natapol2547/iot-ros/src/iot_robot_description/meshes/wheel_link_right_visual.stl

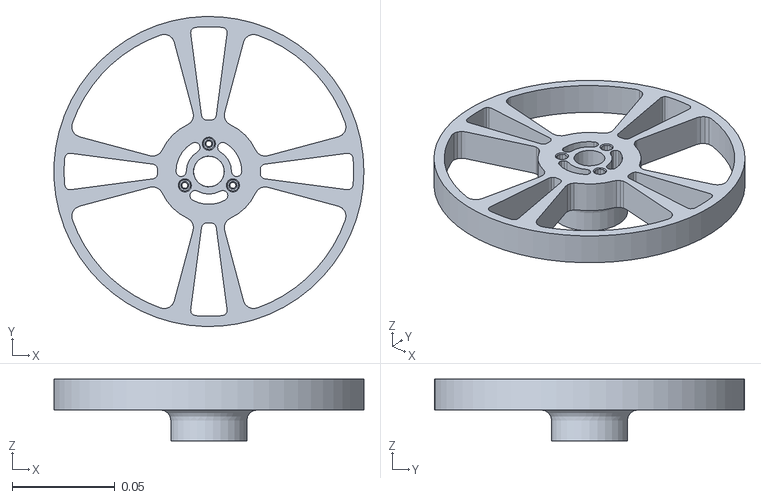
[picture p3: CAD file, 2026-09-09]
src/iot_robot_description/meshes/wheel_link_right_visual.stl
0.151 x 0.151 x 0.03
