natapol2547/iot-ros/src/iot_robot_description/meshes/gizmo_pitch_link_visual.stl

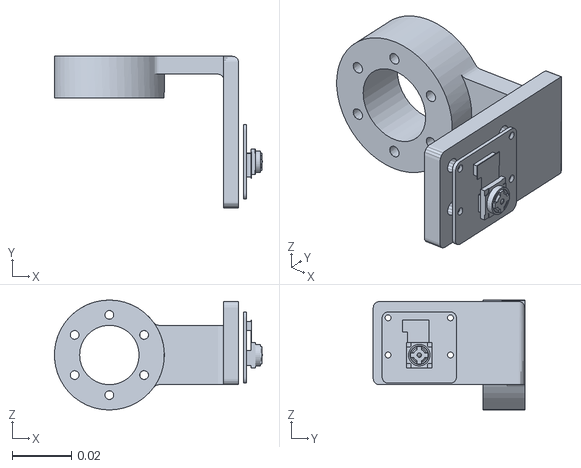
[picture p4: CAD file, 2026-09-09]
src/iot_robot_description/meshes/gizmo_pitch_link_visual.stl
0.07 x 0.051 x 0.037
