natapol2547/iot-ros/src/iot_robot_description/meshes/base_link_visual.stl

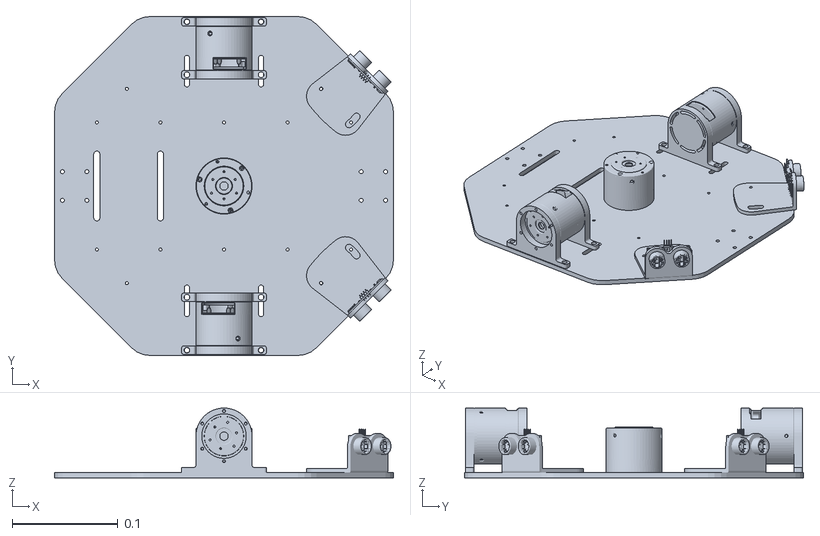
[picture p5: CAD file, 2026-09-09]
src/iot_robot_description/meshes/base_link_visual.stl
0.32 x 0.32 x 0.066
