natapol2547/iot-ros/src/iot_robot_description/meshes/gizmo_yaw_link_visual.stl

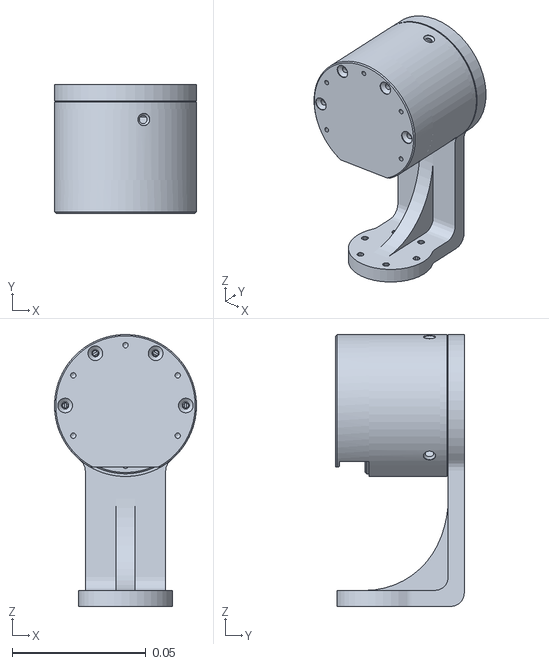
[picture p6: CAD file, 2026-09-09]
src/iot_robot_description/meshes/gizmo_yaw_link_visual.stl
0.053 x 0.048 x 0.102
