natapol2547/iot-ros/src/iot_robot_description/meshes/caster_front_visual.stl

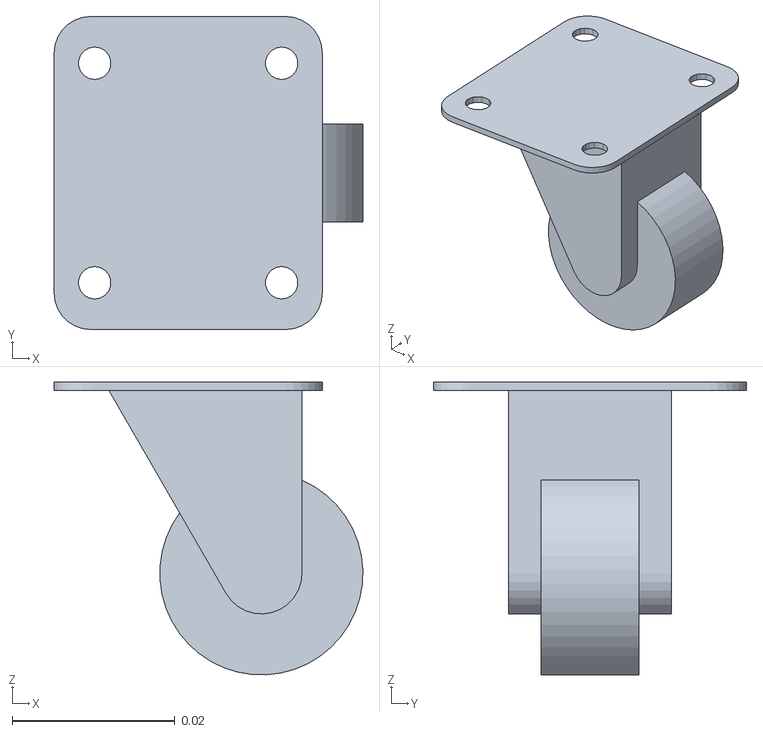
[picture p7: CAD file, 2026-09-09]
src/iot_robot_description/meshes/caster_front_visual.stl
0.038 x 0.0385 x 0.036
