natapol2547/iot-ros/(list of files, cad)

Other CAD files:
src/iot_robot_description/meshes/wheel_link_left_visual.stl
src/iot_robot_description/meshes/caster_back_visual.stl
robot.blend
