natapol2547/iot-ros/src/iot_robot_description/urdf/robot.urdf.xacro

<?xml version="1.0"?>
<!--
  Robot: iot_robot
  Generated by: LinkForge v1.5.1
  https://github.com/arounamounchili/linkforge
  Date: 2026-09-09 17:59:57
-->
<robot xmlns:xacro="http://ros.org/wiki/xacro" name="iot_robot">
    <!-- Links -->
    <link name="base_footprint" />
    <link name="base_link">
        <inertial>
            <origin xyz="0 0 0.033" rpy="0 0 0" />
            <mass value="1.5" />
            <inertia ixx="0.013345" ixy="0" ixz="0" iyy="0.013345" iyz="0" izz="0.0256" />
        </inertial>
        <visual>
            <origin xyz="0 0 0.033" rpy="0 0 0" />
            <geometry>
                <mesh filename="package://iot_robot_description/meshes/base_link_visual.stl" />
            </geometry>
        </visual>
        <collision>
            <origin xyz="0 0 0.033" rpy="0 0 0" />
            <geometry>
                <box size="0.32 0.32 0.066" />
            </geometry>
        </collision>
    </link>
    <link name="caster_back">
        <inertial>
            <origin xyz="0.002624 0 -0.017848" rpy="0 0 0" />
            <mass value="0.1" />
            <inertia ixx="0.000015" ixy="0" ixz="0" iyy="0.000015" iyz="0" izz="0.000015" />
        </inertial>
        <visual>
            <origin xyz="0.002624 0 -0.017848" rpy="0 0 0" />
            <geometry>
                <mesh filename="package://iot_robot_description/meshes/caster_back_visual.stl" />
            </geometry>
        </visual>
        <collision>
            <origin xyz="0.002624 0 -0.017848" rpy="0 0 0" />
            <geometry>
                <sphere radius="0.01925" />
            </geometry>
        </collision>
    </link>
    <link name="caster_front">
        <inertial>
            <origin xyz="0.002497 0 -0.017992" rpy="0 0 0" />
            <mass value="0.1" />
            <inertia ixx="0.000015" ixy="0" ixz="0" iyy="0.000015" iyz="0" izz="0.000015" />
        </inertial>
        <visual>
            <origin xyz="0.002497 0 -0.017992" rpy="0 0 0" />
            <geometry>
                <mesh filename="package://iot_robot_description/meshes/caster_front_visual.stl" />
            </geometry>
        </visual>
        <collision>
            <origin xyz="0.002497 0 -0.017992" rpy="0 0 0" />
            <geometry>
                <sphere radius="0.01925" />
            </geometry>
        </collision>
    </link>
    <link name="gizmo_pitch_link">
        <inertial>
            <origin xyz="0.01654 -0.0195 0" rpy="0 0 0" />
            <mass value="0.2" />
            <inertia ixx="0.000066" ixy="0" ixz="0" iyy="0.000104" iyz="0" izz="0.000125" />
        </inertial>
        <visual>
            <origin xyz="0.01654 -0.0195 0" rpy="0 0 0" />
            <geometry>
                <mesh filename="package://iot_robot_description/meshes/gizmo_pitch_link_visual.stl" />
            </geometry>
        </visual>
    </link>
    <link name="gizmo_yaw_link">
        <inertial>
            <origin xyz="0 0.006 0.05075" rpy="0 0 0" />
            <mass value="0.3" />
            <inertia ixx="0.000315" ixy="0" ixz="0" iyy="0.000328" iyz="0" izz="0.000128" />
        </inertial>
        <visual>
            <origin xyz="0 0.006 0.05075" rpy="0 0 0" />
            <geometry>
                <mesh filename="package://iot_robot_description/meshes/gizmo_yaw_link_visual.stl" />
            </geometry>
        </visual>
    </link>
    <link name="wheel_link_left">
        <inertial>
            <origin xyz="0.000053 0 0.0075" rpy="0 0 0" />
            <mass value="0.2" />
            <inertia ixx="0.000288" ixy="0" ixz="0" iyy="0.000288" iyz="0" izz="0.000568" />
        </inertial>
        <visual>
            <origin xyz="0.00534 0 0" rpy="0 0 0" />
            <geometry>
                <mesh filename="package://iot_robot_description/meshes/wheel_link_left_visual.stl" />
            </geometry>
        </visual>
        <collision>
            <origin xyz="0.000053 0 0.0075" rpy="0 0 0" />
            <geometry>
                <cylinder radius="0.075353" length="0.015" />
            </geometry>
        </collision>
    </link>
    <link name="wheel_link_right">
        <inertial>
            <origin xyz="0.000053 0 0.0075" rpy="0 0 0" />
            <mass value="0.2" />
            <inertia ixx="0.000288" ixy="0" ixz="0" iyy="0.000288" iyz="0" izz="0.000568" />
        </inertial>
        <visual>
            <origin xyz="0.00534 0 0" rpy="0 0 0" />
            <geometry>
                <mesh filename="package://iot_robot_description/meshes/wheel_link_right_visual.stl" />
            </geometry>
        </visual>
        <collision>
            <origin xyz="0.000053 0 0.0075" rpy="0 0 0" />
            <geometry>
                <cylinder radius="0.075353" length="0.015" />
            </geometry>
        </collision>
    </link>
    <!-- Joints -->
    <joint name="base_joint" type="fixed">
        <origin xyz="0 0 0.035875" rpy="0 0 0" />
        <parent link="base_footprint" />
        <child link="base_link" />
    </joint>
    <joint name="caster_back_joint" type="fixed">
        <origin xyz="-0.141001 0 0.000126" rpy="0 0 0" />
        <parent link="base_link" />
        <child link="caster_back" />
    </joint>
    <joint name="caster_front_joint" type="fixed">
        <origin xyz="0.141 0 0" rpy="0 0 0" />
        <parent link="base_link" />
        <child link="caster_front" />
    </joint>
    <joint name="gizmo_pitch_joint" type="revolute">
        <origin xyz="0 0.033 0.075" rpy="0 0 0" />
        <parent link="gizmo_yaw_link" />
        <child link="gizmo_pitch_link" />
        <axis xyz="0 1 0" />
        <limit effort="10" velocity="1" lower="-0.785398" upper="0" />
    </joint>
    <joint name="gizmo_yaw_joint" type="revolute">
        <origin xyz="0 0 0.048" rpy="0 0 0" />
        <parent link="base_link" />
        <child link="gizmo_yaw_link" />
        <axis xyz="0 0 1" />
        <limit effort="10" velocity="1" lower="-0.785398" upper="0.785398" />
    </joint>
    <joint name="wheel_joint_left" type="continuous">
        <origin xyz="0 0.167 0.0395" rpy="1.570796 0 -3.141593" />
        <parent link="base_link" />
        <child link="wheel_link_left" />
        <axis xyz="0 0 1" />
        <limit effort="7" velocity="19" />
    </joint>
    <joint name="wheel_joint_right" type="continuous">
        <origin xyz="0 -0.167 0.0395" rpy="1.570796 0 0" />
        <parent link="base_link" />
        <child link="wheel_link_right" />
        <axis xyz="0 0 -1" />
        <limit effort="7" velocity="19" />
    </joint>

    <!-- Camera body frame on the pan/tilt head (REP 103: x forward, y left, z up) -->
    <link name="camera_link" />
    <joint name="camera_joint" type="fixed">
        <origin xyz="0.0515 -0.03 0" rpy="0 0 0" />
        <parent link="gizmo_pitch_link" />
        <child link="camera_link" />
    </joint>

    <!-- Optical frame (REP 103: z forward, x right, y down); images are expressed in this frame -->
    <link name="camera_optical_frame" />
    <joint name="camera_optical_joint" type="fixed">
        <origin xyz="0 0 0" rpy="${-pi/2} 0 ${-pi/2}" />
        <parent link="camera_link" />
        <child link="camera_optical_frame" />
    </joint>

    <!-- HC-SR04 ultrasonic sensors on the two front chamfers, turned 45° outwards. The origin
         sits just in front of the transducer faces (their centre is 30 mm above base_link) and
         x points along the beam, so sensor_msgs/Range readings are measured from this frame -->
    <link name="ultrasonic_left_link" />
    <joint name="ultrasonic_left_joint" type="fixed">
        <origin xyz="0.144 0.114 0.030" rpy="0 0 ${pi/4}" />
        <parent link="base_link" />
        <child link="ultrasonic_left_link" />
    </joint>
    <link name="ultrasonic_right_link" />
    <joint name="ultrasonic_right_joint" type="fixed">
        <origin xyz="0.144 -0.114 0.030" rpy="0 0 ${-pi/4}" />
        <parent link="base_link" />
        <child link="ultrasonic_right_link" />
    </joint>

    <!-- LSM9DS1 IMU. imu_link has the magnetometer's axes, the right-handed set that
         lsm9ds1_node reports in (iot_robot_drivers/lsm9ds1.py): seen from above with the
         chip's pin 1 dot at the top left, x points left, y down the page and z up out of it.
         PLACEHOLDER POSE: measure where the chip sits relative to base_link and how it is
         turned, then set xyz and rpy. To check the rotation, stand the robot level: the
         imu_link axis pointing up reads about +9.8 m/s^2 in imu/data_raw, and turning the
         robot to the left gives a positive angular velocity about that same axis. With
         rpy 0 0 0 both must show on z -->
    <link name="imu_link" />
    <joint name="imu_joint" type="fixed">
        <origin xyz="0 0 0.05" rpy="0 0 0" />
        <parent link="base_link" />
        <child link="imu_link" />
    </joint>

</robot>
