natapol2547/iot-ros/src/iot_robot_bringup/config/controllers.yaml

controller_manager:
  ros__parameters:
    # One CAN round trip per cycle: a speed command out to each motor, their status frames
    # in. The motors should send status at 100-200 Hz (twice this rate or more), because
    # cubemars_hardware warns on every cycle that finds no new frame from a motor
    update_rate: 50
    enforce_command_limits: true

joint_state_broadcaster:
  ros__parameters:
    type: joint_state_broadcaster/JointStateBroadcaster

diff_drive_controller:
  ros__parameters:
    type: diff_drive_controller/DiffDriveController
    left_wheel_names: ["wheel_joint_left"]
    right_wheel_names: ["wheel_joint_right"]
    # Same geometry as the simulation (iot_robot_mujoco/config/controllers.yaml)
    wheel_separation: 0.349
    wheel_radius: 0.0754
    base_frame_id: base_footprint
    odom_frame_id: odom
    enable_odom_tf: true
    publish_rate: 50.0
    cmd_vel_timeout: 0.5
    # Odometry from wheel speed, not position: the motor reports position as an int16 in
    # 0.1 deg that saturates at +-3200 deg (about 4 m of travel), after which position
    # odometry would stop counting. Speed has no such limit, and at 50 Hz with 100 Hz
    # status frames integrating it loses little
    position_feedback: false
    # Room for the web page's turbo mode (3 x 0.4 m/s and 3 x 1.5 rad/s, the same as the
    # simulation). The AK45-10 is rated 150 rpm, about 1.18 m/s at this wheel radius, so
    # full turbo is at the motor's limit. The web page's obstacle guard assumes the
    # max_deceleration below (web_controller.yaml obstacle_deceleration)
    linear.x.max_velocity: 1.2
    linear.x.min_velocity: -1.2
    linear.x.max_acceleration: 1.0
    linear.x.max_deceleration: -2.0
    angular.z.max_velocity: 4.5
    angular.z.min_velocity: -4.5
    angular.z.max_acceleration: 4.0
    angular.z.max_deceleration: -8.0

# Pan/tilt position commands (std_msgs/Float64MultiArray on /gizmo_controller/commands,
# [yaw, pitch] in rad), same as the simulation. Only loaded in gizmo_mode can. The motor
# plugin clamps the commands to the URDF joint limits and moves at most at the URDF
# velocity limit, so a jump in the command becomes a smooth move. With the real motors the
# URDF switches the controller manager's joint limiter off for these joints (the plugin is
# the only limiter), so enforce_command_limits applies to the wheels only
gizmo_controller:
  ros__parameters:
    type: position_controllers/JointGroupPositionController
    joints:
      - gizmo_yaw_joint
      - gizmo_pitch_joint
