natapol2547/iot-ros/src/iot_robot_bringup/config/motors.yaml

# The four CubeMars AK45-10 motors on the CAN bus, one entry per joint.
#
# This is the only place the motor CAN IDs are set. robot.launch.py (URDF and CAN
# pre-flight check), cubemars_tool and the systemd stop step all read this file.
# Which joint each ID below sits on was confirmed against the hardware on 2026-09-24.
# Replacing a motor, or giving one a new ID with the Upper Computer, changes the mapping
# again; re-check it with
#   pixi run -e robot can-identify
# (docs/todo.md); with --write it updates the can_id values here and keeps everything
# else. Edits take effect at the next launch (sudo systemctl restart iot-robot for the
# service) without a rebuild, because `pixi run build` installs this file as a symlink
# (--symlink-install).
#
# Keys per joint:
#   can_id         CAN ID set on the motor with the CubeMars Upper Computer and R-Link
#                  (1-254, unique on the bus). Confirmed on the hardware, 2026-09-24
#   direction      1 or -1: flips the motor so that a positive command moves the
#                  joint in its positive URDF direction (wheels: robot forward;
#                  yaw: turn left; pitch: tilt down). All four checked on the robot,
#                  2026-09-25; re-check with cubemars_tool jog after replacing or
#                  reconfiguring a motor
#   zero_on_start  gizmo joints only. The motors cannot remember their position over
#                  a power cycle, so the pose the gizmo is in when the robot software
#                  starts becomes the joint zero (docs/checklist.md)
motors:
  wheel_joint_left:
    can_id: 12
    direction: 1  # checked by driving forward on the robot, 2026-09-25
  wheel_joint_right:
    can_id: 13
    direction: -1  # checked with cubemars_tool jog and by driving forward, 2026-09-25
  gizmo_yaw_joint:
    can_id: 10
    direction: 1  # checked with cubemars_tool jog, 2026-09-25
    zero_on_start: true
  gizmo_pitch_joint:
    can_id: 11
    direction: 1  # checked with cubemars_tool jog, 2026-09-25
    zero_on_start: true
