natapol2547/iot-ros/(commit log)

2026-09-10 fix: robot wheel origin
    [robot.urdf.xacro]
2026-09-13 add: mujoco sim
    [iot_robot_sim.urdf.xacro, mujoco_inputs.xml, scene.xml]
2026-09-13 feat: sim with teleop
    [controllers.yaml, iot_robot_sim.urdf.xacro]
2026-09-13 feat: ball follower
    [controllers.yaml]
2026-09-13 feat: person following
    [scene.xml]
2026-09-21 feat: person re-identification with OSNet
    - reid.py: OSNet x0.25 encoder and an enrolled/recent embedding gallery
    - person_detector: follow the best ReID match, enroll by raising both
    hands for 2 s or via the ~/enroll service, ~/forget to clear
    - target_follower: stand still until a target is seen, stop searching
    after search_timeout
    - scene: faces on the mannequins and a second mannequin for ReID tests
    - pixi tasks: enroll, forget
    [scene.xml]
2026-09-21 feat: simulated ultrasonic sensors
    Adds ultrasonic_left_link and ultrasonic_right_link frames to the description
    and models each HC-SR04 as five MuJoCo rangefinder rays across its cone.
    scan_to_range turns the resulting LaserScans into the sensor_msgs/Range
    messages the STM32 bridge publishes on the real robot. The scene gains a wall
    and a crate, outside the camera's view, for the sensors to see.
    [iot_robot_sim.urdf.xacro, mujoco_inputs.xml, robot.urdf.xacro, scene.xml]
2026-09-21 feat: browser controller for the robot
    iot_robot_web serves a page on port 8080 that anyone on the LAN can open. One
    client drives at a time (joystick or WASD, published on /cmd_vel/web at
    twist_mux priority 90), everyone can engage the E-stop, and the page switches
    between driving, ball following and person following, aims the camera gizmo,
    and streams the camera or detector image as MJPEG.
    Both ultrasonic sensors are shown as blinking green, yellow and red lights
    whose blink rate rises as the distance falls. Forward motion is refused below
    obstacle_stop_distance and, with require_ultrasonic (default), while a sensor
    is stale or reported faulty.
    The E-stop shares /e_stop with other publis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
    [web_controller.yaml]
2026-09-21 feat: real robot bringup, drivers and Raspberry Pi deployment
    - iot_robot_bringup: robot.launch.py for the Pi (CubeMars wheels over CAN,
    camera_ros with the IMX219, STM32 bridge, twist_mux, web controller) with a
    mock:=true mode that needs no hardware. The web E-stop is engaged at start
    (start_estopped:=true), so a restart never drives by itself.
    - cubemars_hardware (submodule) is the upstream ros2_control plugin.
    cubemars_hardware_safe subclasses it to stop both wheels on deactivate,
    shutdown, motor faults and a 100 ms status silence, and latches that stop.
    robot.launch.py also stops the motors when ros2_control_node exits.
    - iot_robot_drivers: stm32_bridge (Nucleo serial protoc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
    [controllers.yaml, iot_robot.urdf.xacro]
2026-09-21 docs: wiring diagrams and parts list for the real robot
    Covers power distribution from the 6S LiPo (main fuse, E-stop, buck converter
    for the Pi, per-branch fuses, battery sense), the CAN bus harness and
    termination for the two AK45-10 drives, the Nucleo-F401RE pinout with the
    HC-SR04 ECHO dividers, and the camera ribbon. Includes a parts list, a safety
    checklist before the first power-on, and open items that depend on the exact
    parts. The SVGs are generated from docs/wiring/src.
2026-09-21 docs: README for the web controller and real hardware
    Adds the hardware documents, the iot-stm32 firmware repository, the pixi
    environments and new tasks, the new packages and topics, the Step 8 progress
    and the lessons learned while building them.
2026-09-22 fix(pixi): only source install/ built with the active environment
    install/setup.bash chains to the pixi environment it was built with, so
    sourcing a default-environment build under -e robot put the default
    environment's compiler and libraries first on PATH and broke the robot
    build of cubemars_hardware (can_frame.len). The activation script now
    skips install/ built by another environment and says how to rebuild.
2026-09-22 feat: LSM9DS1 IMU on the Raspberry Pi's I2C bus
    - lsm9ds1 driver (smbus2) with datasheet scaling to SI units, the
    magnetometer axes mapped into the accelerometer/gyroscope frame and an
    optional gyroscope bias estimate at start-up
    - lsm9ds1_node publishes /imu/data_raw and /imu/mag and retries when the
    sensor is missing instead of exiting
    - imu.launch.py runs it with imu_filter_madgwick (/imu/data, magnetometer
    off by default because of the motors nearby)
    - imu_link in the description URDF, pose still to be measured
    - install.sh enables I2C with raspi-config, installs i2c-tools and adds
    the user to the i2c group
    [robot.urdf.xacro]
2026-09-22 feat: wheels and gizmo on four CAN motors configured from motors.yaml
    All four CubeMars AK45-10 motors (two wheels, gizmo yaw and pitch) are
    driven by the Raspberry Pi over CAN. Their CAN IDs and directions live in
    one file, config/motors.yaml, read by the URDF, the CAN pre-flight check,
    cubemars_tool and the systemd stop step.
    - cubemars_hardware_safe: per-joint direction on every command and
    state; gizmo position commands clamped to the URDF limits and slewed at
    the URDF velocity limit; zero_on_activate sets a temporary origin,
    because the single-encoder motors lose their position at power-off;
    optional stall guard; every stop path still stops every motor of the
    component
    - URDF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
    [controllers.yaml, iot_robot.urdf.xacro, motors.yaml]
2026-09-22 docs: four CAN motors, IMU, Pi 4, one-time to-do list and session checklist
    - docs/todo.md: the one-time setup, in order (wiring, R-Link settings,
    identifying the motor IDs, directions, gizmo zero pose, IMU, first
    power-on)
    - docs/checklist.md: what to do every session, since the gizmo motors do
    not remember their position over a power cycle
    - wiring guide and diagrams: four motors on the CAN bus, XT60, E-stop on
    the motor supply, Pi 4 camera ribbon, HC-SR04P, new LSM9DS1 diagram
    - hardware.md, deploy/README.md, README.md and web.md updated to match
2026-09-22 refactor: all motors controlled by the Raspberry Pi; remove the Nucleo servo path
    The Nucleo-F401RE now only reads sensors (ultrasonics and optional battery
    voltage). All four CubeMars AK45-10 motors, wheels and gizmo, are driven by
    the Raspberry Pi over CAN through ros2_control.
    - gizmo_mode accepts only can (default) and fixed; servo is rejected by the
    launch file, the URDF, stm32_bridge and cubemars_tool
    - stm32_bridge no longer writes to the board: the G: command, the servo
    parameters and the pose resend on reconnect are gone
    - stm32_protocol drops format_gizmo, parse_gizmo and joint_to_servo_deg;
    fake_stm32 drops its G: handling and reports firmware 1.2.0
    - Tests: servo tests rem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
    [iot_robot.urdf.xacro, mujoco_inputs.xml]
2026-09-24 fix: confirmed CAN ID to joint mapping (yaw 10, pitch 11, left 12, right 13)
    Checked against the hardware on 2026-09-24. The wheels are on the high IDs,
    the opposite of the previous assumption, so motors.yaml, the docs, the wiring
    diagrams and the test fixtures all had to change.
    - motors.yaml: the can_id values, and a header that separates the confirmed
    mapping from the direction values, which are still assumptions
    - Docs and diagrams: the "assumed" framing is gone, can-identify is now
    documented as the way to re-check the mapping after a motor swap
    - Sample log lines were re-derived by running the tools on a virtual CAN bus.
    They list IDs as 12, 13, 10, 11: check and the launch walk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
    [motors.yaml]
2026-09-24 fix(pixi): point libcamera at its IPA proxy and tuning files
    The conda-forge libcamera build loses file names appended to its
    compiled-in install paths: the prefix is rewritten inside the binary after
    the compiler fixed the string length, so the result carries a run of NUL
    bytes. libcamera then executes the directory libexec/libcamera instead of
    the IPA proxy worker, the worker call times out and camera_node exits with
    "no cameras available"; the imx219 tuning file is not found either.
    LIBCAMERA_IPA_PROXY_PATH and LIBCAMERA_IPA_CONFIG_PATH are read at run time
    and avoid the problem. Checked on the Raspberry Pi 4: cam lists the imx219
    and captures at 15 fps.
2026-09-25 fix(camera): vendor camera_ros 0.7.0 patched for an isolated libcamera IPA
    The conda-forge libcamera build ships IPA modules whose signatures do not
    verify, so libcamera runs the Raspberry Pi IPA in a separate process. The
    upstream camera_ros passes a default-constructed ControlList to
    Camera::start(); without a ControlIdMap the IPA serializer encodes it as a
    list of V4L2 controls and the proxy worker aborts with "A list of V4L2
    controls requires a ControlInfoMap", so the node never publishes images.
    Bind the list to libcamera::controls::controls and rename the component
    library so the overlay camera_node, whose DT_RPATH points at the pixi
    environment, does not dlopen the unpatched upstream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
2026-09-25 fix(deploy): bring up can0 on gs_usb adapters without bus-off restart
    systemd-networkd refused the whole [CAN] section on the Pi's gs_usb adapter
    ("Device doesn't support restart from Bus Off") and left can0 down after
    every boot. Drop RestartSec= from the network file. can_up.sh still asks for
    restart-ms 100 and falls back to setting only the bitrate when the driver
    rejects it.
2026-09-25 fix(bringup): both wheel motors turn backward for a positive command
    Checked with cubemars_tool jog on the robot: a positive speed turned each
    wheel so that the robot would roll backward.
    [motors.yaml]
2026-09-25 fix(drivers): stop cubemars_tool moves when a motor does not follow its speed
    On the robot the left wheel drive ran at -16.6 rad/s when +0.5 rad/s was
    commanded: its speed loop pushes the wrong way, a sign of a mismatched
    encoder or phase calibration. jog limits the gizmo travel by speed x time,
    which does not hold for such a motor, and a zero-speed brake drives it on.
    jog and the identify wiggle now stop when the measured speed differs from
    the command by more than max(1 rad/s, |command|) and only release the
    motor. The left wheel direction goes back to the unverified assumption
    until the drive is recalibrated.
    [motors.yaml]
2026-09-25 docs(hardware): recognise and recalibrate a motor that does not follow its speed
2026-09-25 fix(bringup): wheel directions confirmed by driving the robot forward
    [motors.yaml]
2026-09-25 fix(bringup): gizmo directions confirmed with cubemars_tool jog
    [motors.yaml]
2026-09-25 feat(web): turbo mode lets the speed slider reach 300 %
    A Turbo button next to the speed slider raises its maximum to turbo_speed
    (3.0 by default, 1.2 m/s and 4.5 rad/s). The server clamps the slider to
    that value, so no client can exceed it. Turbo always starts off and a
    reload never restores a turbo speed.
    diff_drive_controller limits are raised to match on the robot and in
    the simulation. The obstacle guard now adds the braking distance at the
    commanded speed to obstacle_stop_distance (obstacle_reaction_time,
    obstacle_deceleration), so fast commands are refused early enough to stop,
    and the page reports whichever obstacle is holding the robot back.
    [controllers.yaml, web_controller.yaml]
